TS-Truong/Wireless-Power-Transfer/Figures/Initial design - 13.56MHz/Class E amplifier switching.png

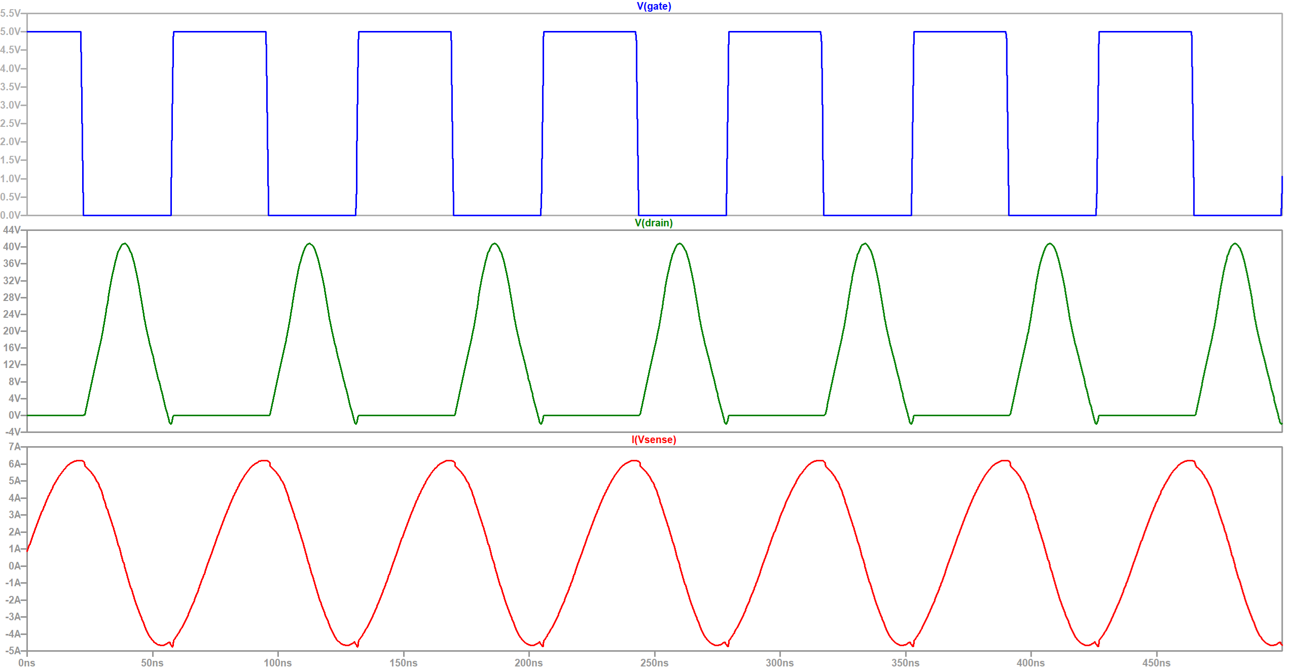
Figures/Initial design - 13.56MHz/Class E amplifier switching.png
