TS-Truong/Wireless-Power-Transfer/Figures/Proof of concept - 10MHz/Class E amplifier switching.png

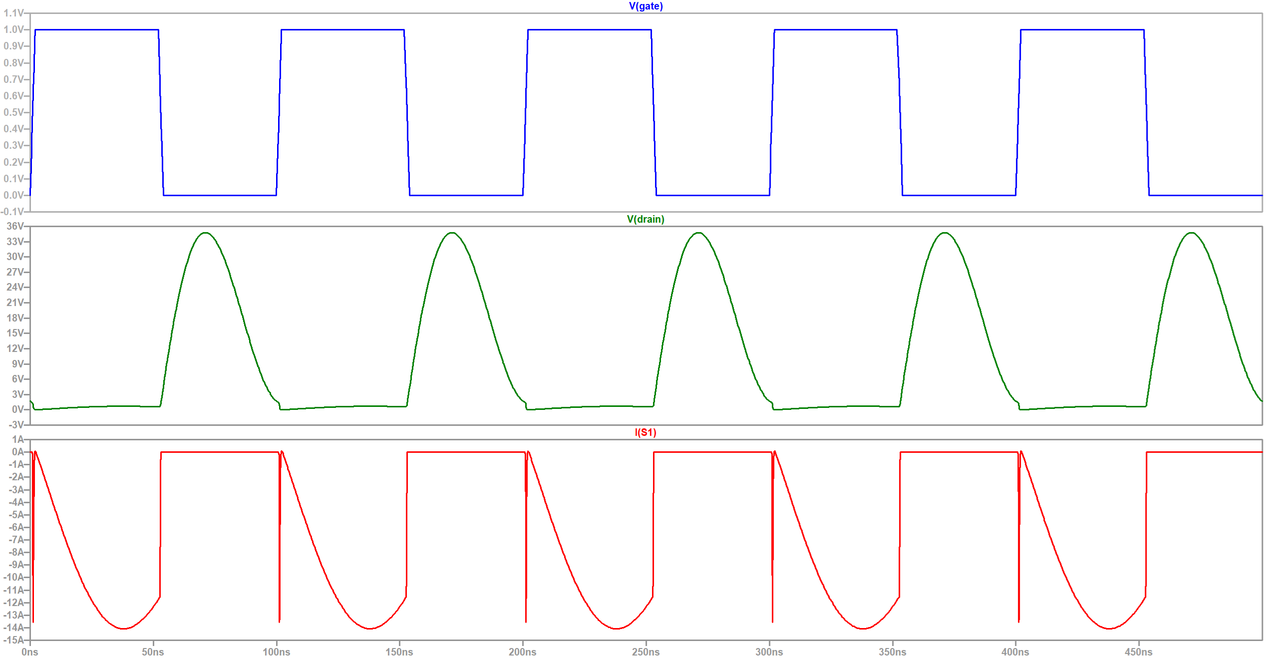
Figures/Proof of concept - 10MHz/Class E amplifier switching.png
