TS-Truong/Wireless-Power-Transfer/LTspice/final design - 6.78MHz/Class E amplifier.asc

CR: cap; 1n
Csh: cap; 200p
LC: ind; 1µ
LR: ind; 1µ
RL: res; 5
U1: EPC2207
Vdc: voltage; 20
Vgate: voltage; PULSE(0 5 0 1n 1n 73.746n 147.493n)
Vsense: voltage; 0
Named nets: 0, GATE, DRAIN, OUTPUT
.tran 0 50u 49u 0.1n
6.78 MHz GaN Class E Amplifier
