TS-Truong/Wireless-Power-Transfer/LTspice/initial design - 13.56MHz/Class E amplifier.asc

CR: cap; 1.2n
Csh: cap; 100p
LC: ind; 100µ
LR: ind; 150n
RL: res; 0.5
U1: EPC2034C
Vdc: voltage; 10
Vgate: voltage; PULSE(0 5 0 1n 1n 36.873n 73.746n)
Vsense: voltage; 0
Named nets: 0, DRAIN, GATE, OUTPUT
.tran 0 50u 49.5u 0.1n
13.56 MHz GaN Class E Power Amplifier
