TS-Truong/Wireless-Power-Transfer/LTspice/proof of concept - 10MHz/Class E amplifier.asc

CR: cap; 4.227n
Csh: cap; 3.347n
LC: ind; 10µ
LR: ind; 79.58n
RL: res; 1
S1: sw; GaN_SW
Vdc: voltage; 10
Vgate: voltage; PULSE(0 1 0 2n 2n 0.05u 0.1u)
Named nets: 0, OUTPUT, DRAIN, GATE
.tran 0 50u 49.5u 0.1n
.model GaN_SW SW(Ron=50m Roff=1G Vt=0.5 Vh=-0.1)
Proof of concept
