TS-Truong/Wireless-Power-Transfer/ltspice/final-6.78MHz/Class E Amplifier (6.78MHz).asc

CR: cap; 1n
Csh: cap; 200p
LC: ind; 1µ
LR: ind; 1µ
RL: res; 5
U2: EPC2207
V1: voltage; PULSE(0 5 0 18n 18n 73.746n 147.493n)
V2: voltage; 20
Named nets: 0
.tran 0 50u 35u 0.1n
