TS-Truong/Wireless-Power-Transfer/ltspice/initial-13.56MHz/Class E Amplifier (13.56MHz).asc

CR: cap; 1.2n
Csh: cap; 100p
LC: ind; 100µ
LR: ind; 150n
RL: res; 0.5
U1: EPC2034C
V1: voltage; PULSE(0 5 0 2n 2n 36.873n 73.746n)
V2: voltage; 10
Named nets: 0
.tran 0 40u 35u 0.1n
